LibreSolar/uext-esp32/README.md

# WiFi/Bluetooth communication board based on ESP32 for UEXT connector

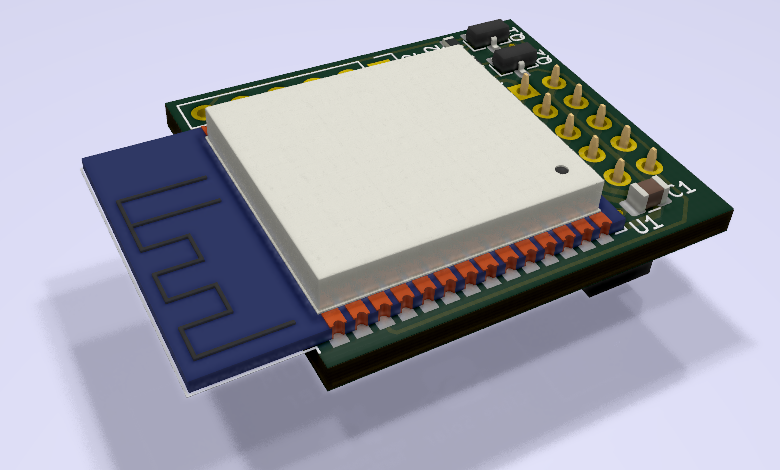
[picture p1: UEXT_ESP32.png]
Top side of the PCB


## Features

- UEXT connector to communicate with host MCU via UART
- Separate programming connector
