LibreSolar/uext-esp32/UEXT_ESP32.pdf

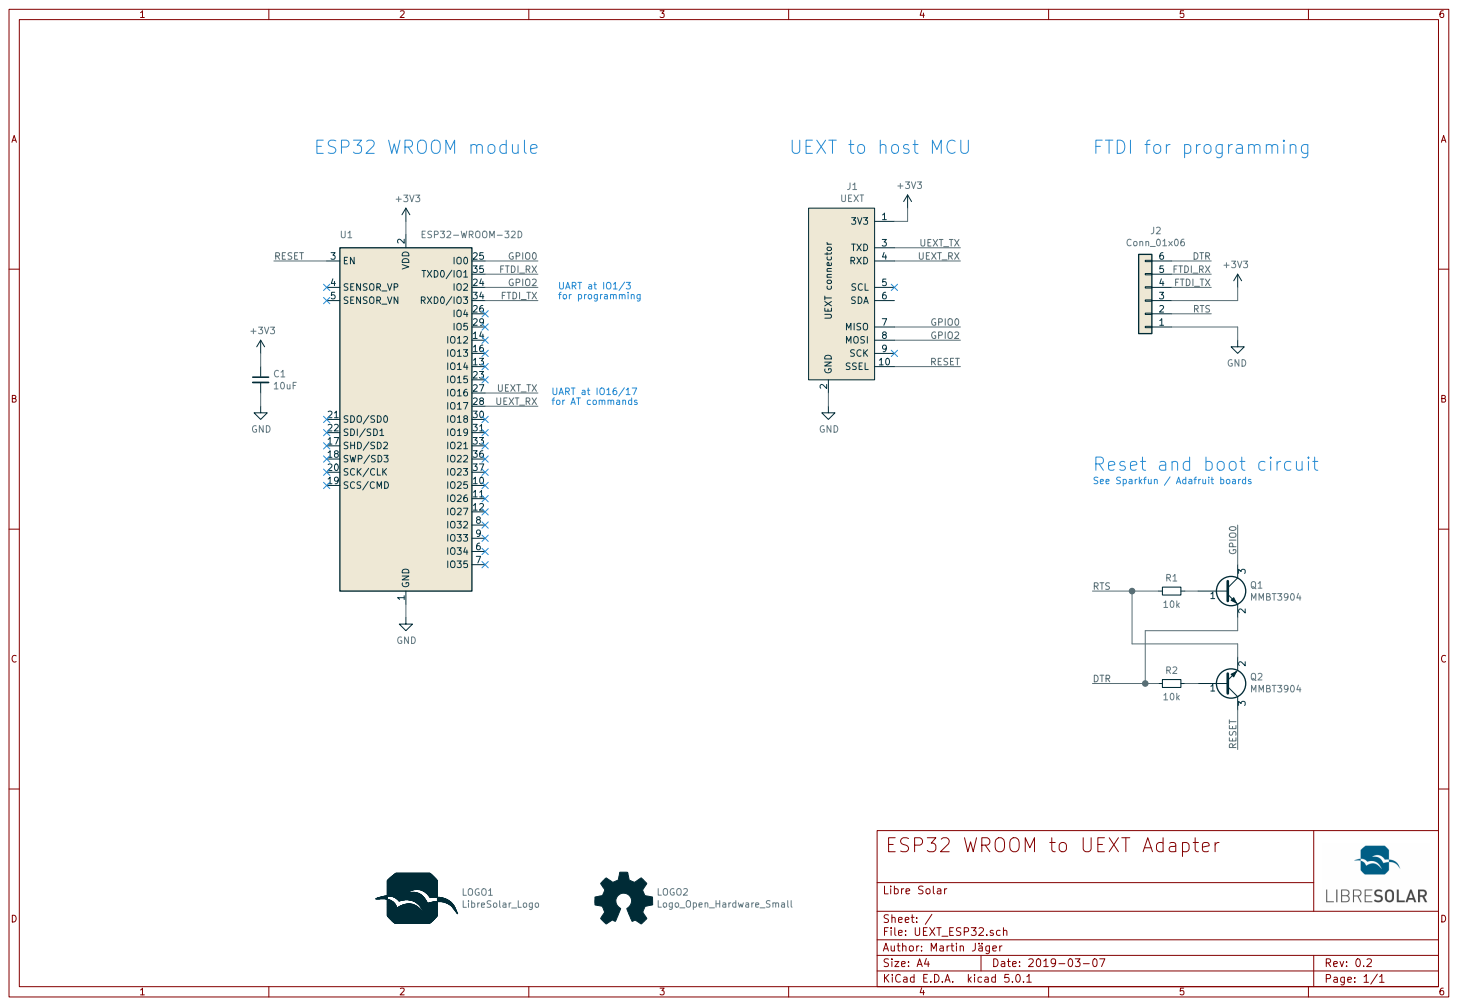
[picture p2: page 1]

2 SCK/CLK 20 SDO/SD0 21 SDI/SD1 22

2 TXD 3 SCL 5 SDA 6 MISO 7 MOSI 8 SCK 9

UART at IO1/3
for programming UART at IO16/17

Reset and boot circuit

See Sparkfun / Adafruit boards

ESP32 WROOM to UEXT Adapter

File: UEXT_ESP32.sch Sheet: / Libre Solar Author: Martin Jäger
