LibreSolar/uext-esp32/UEXT_ESP32.kicad_pcb

## KiCad design UEXT_ESP32.kicad_pcb (2019-10-12)

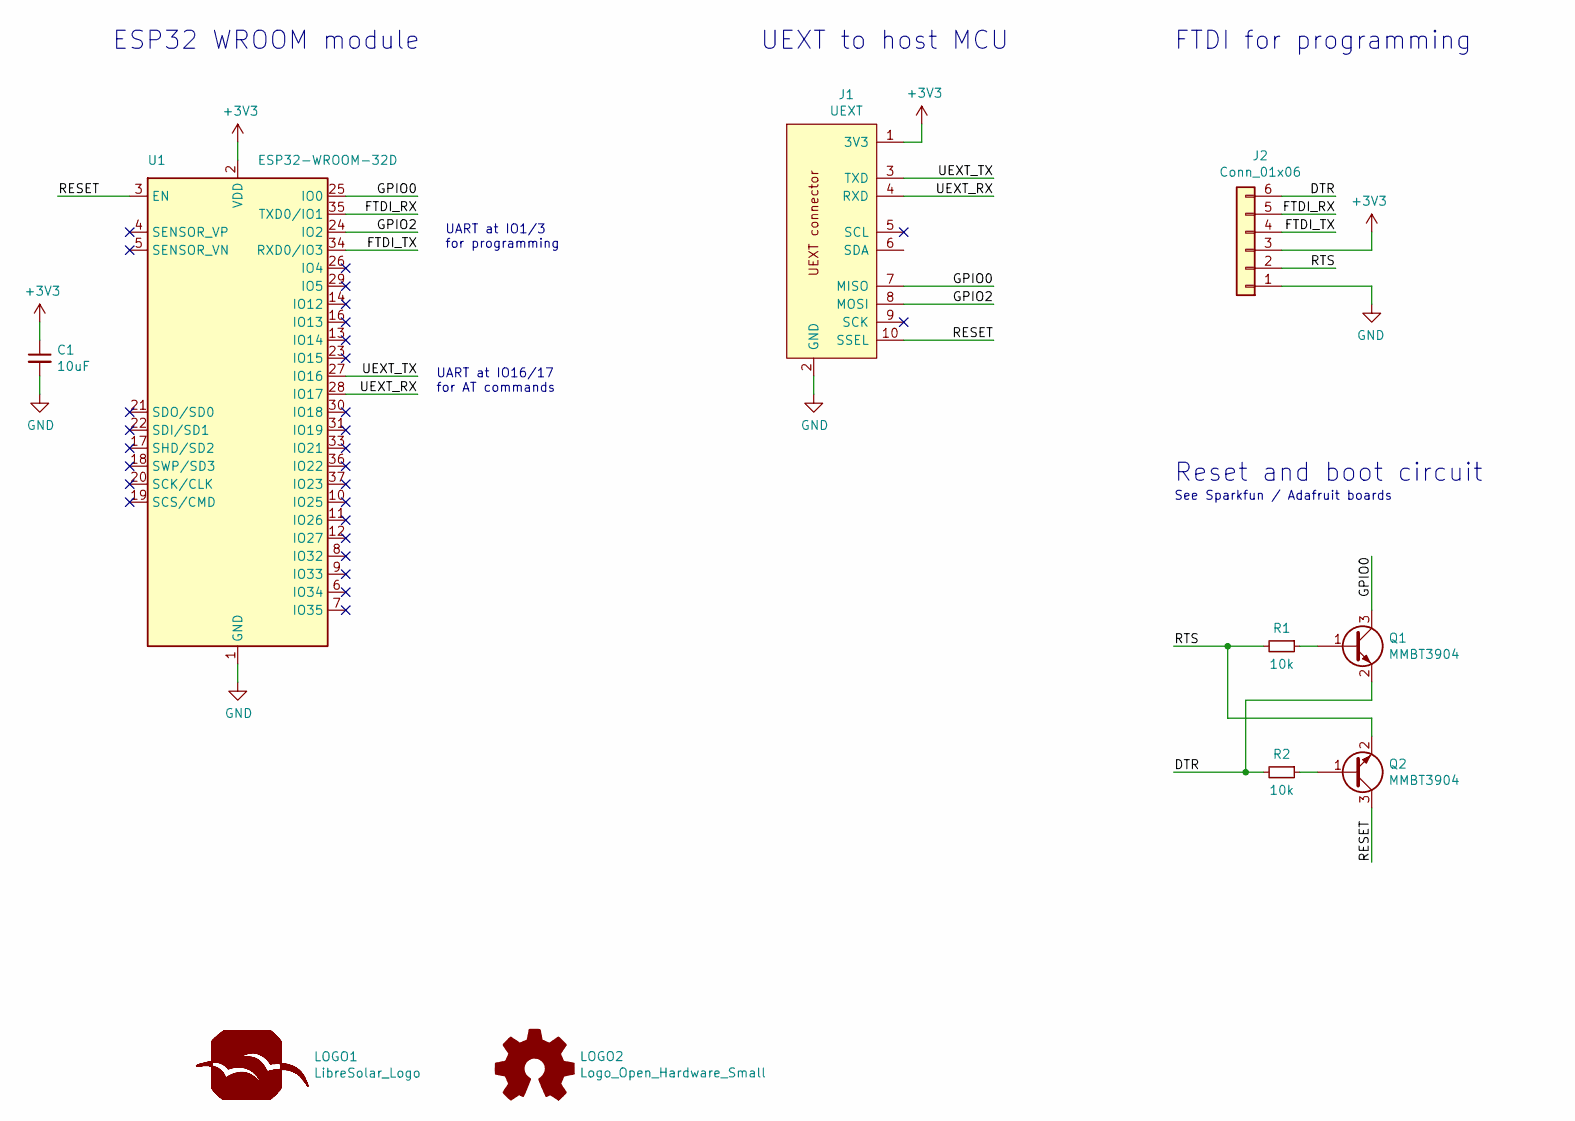
[picture p3: schematic UEXT_ESP32.sch, ESP32 WROOM to UEXT Adapter]

Parts:
C1: 10uF; C_0805_2012; PartNumber GRM21BR61C106KE15L
J1: UEXT; PinSocket_2x05_P2.54mm_Vertical; PartNumber SFH11-PBPC-D05-ST-BK
J2: Conn_01x06; PinHeader_1x06_P2.54mm_Vertical
LOGO1: LibreSolar_Logo; LIBRESOLAR_LOGO
LOGO2: Logo_Open_Hardware_Small; OSHW-Logo_5.7x6mm_SilkScreen
Q1, Q2: MMBT3904; SOT-23
R1, R2: 10k; R_0603_1608; PartNumber RC0603FR-0710KL
U1: ESP32-WROOM-32D; ESP32-WROOM-32

Connections:
+3V3: C1.1, J1.1 (3V3), J2.3, U1.2 (VDD)
/DTR: J2.6, Q1.2 (E), R2.2
/FTDI_RX: J2.5, U1.35 (TXD0/IO1)
/FTDI_TX: J2.4, U1.34 (RXD0/IO3)
/GPIO0: J1.7 (MISO), Q1.3 (C), U1.25 (IO0)
/GPIO2: J1.8 (MOSI), U1.24 (IO2)
/RESET: J1.10 (SSEL), Q2.3 (C), U1.3 (EN)
/RTS: J2.2, Q2.2 (E), R1.2
/UEXT_RX: J1.4 (RXD), U1.28 (IO17)
/UEXT_TX: J1.3 (TXD), U1.27 (IO16)
GND: C1.2, J1.2 (GND), J2.1, U1.1 (GND), U1.15 (GND), U1.38 (GND)
unnamed: Q1.1 (B), R1.1
unnamed: Q2.1 (B), R2.1

Notes on the sheet:
UART at IO1/3 for programming
UART at IO16/17 for AT commands
See Sparkfun / Adafruit boards
Reset and boot circuit
FTDI for programming
UEXT to host MCU
ESP32 WROOM module

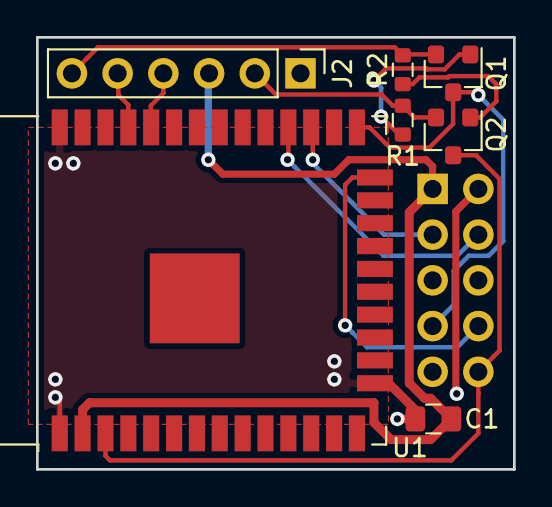
[picture p4: board UEXT_ESP32.kicad_pcb from above]

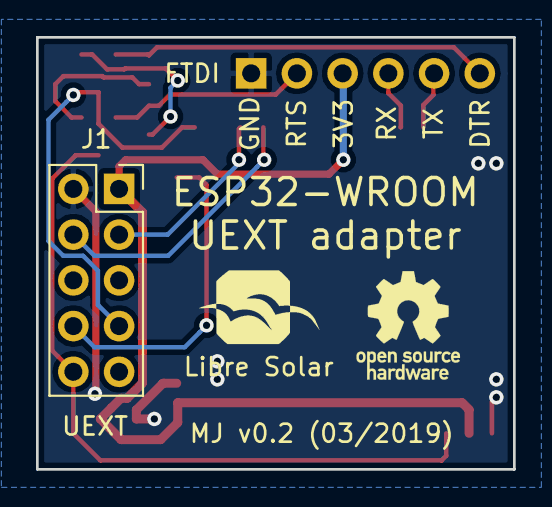
[picture p5: board UEXT_ESP32.kicad_pcb from below]

Board: 2 copper layers, 26.5 x 24.0 mm, 10 parts (3 on the bottom side), 13 nets.
